TroelsG/Kinefox/Graphics/Pictures/Unassembled_casing.jpg

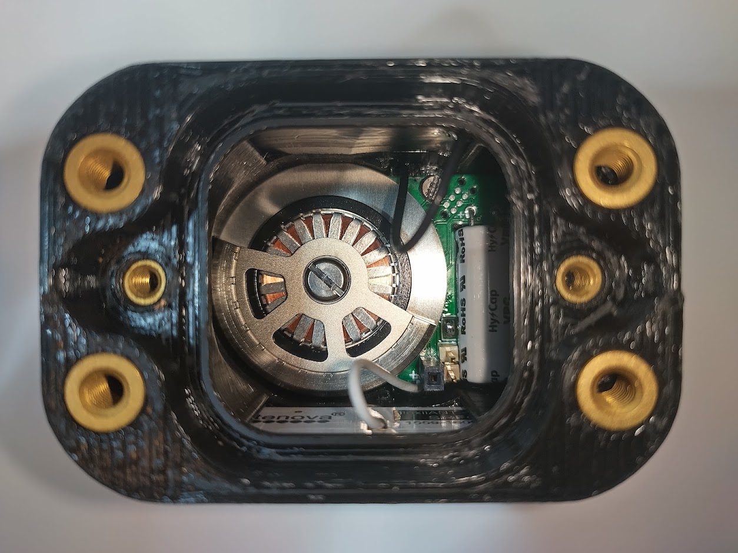
Graphics/Pictures/Unassembled_casing.jpg
