TroelsG/Kinefox/Graphics/Pictures/Assembled_collar.jpg

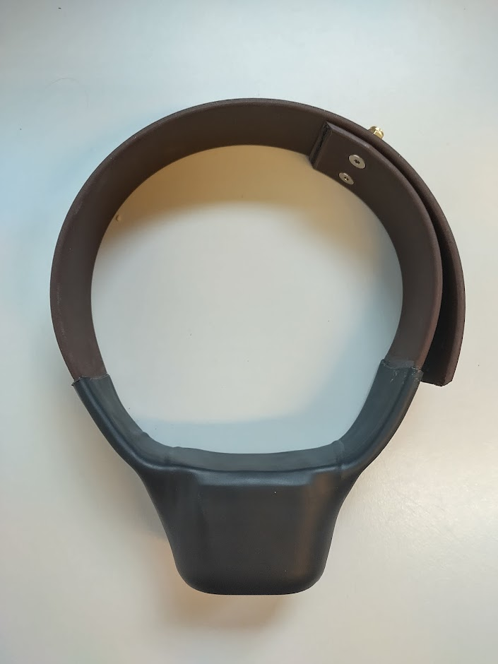
Graphics/Pictures/Assembled_collar.jpg
