TroelsG/Kinefox/README.md

# Kinefox
The wildlife tracker powered by kinetic energy
