TroelsG/Kinefox/Graphics/Pictures/Custom_wire_antenna.jpeg

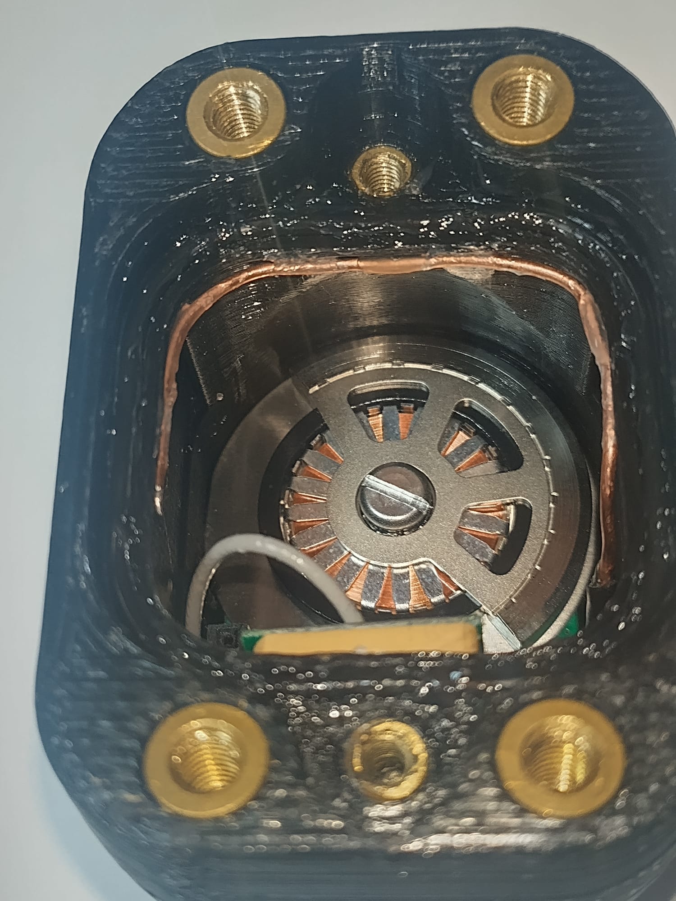
Graphics/Pictures/Custom_wire_antenna.jpeg
