TroelsG/Kinefox/Graphics/Pictures/Dog1_Balto.jpg

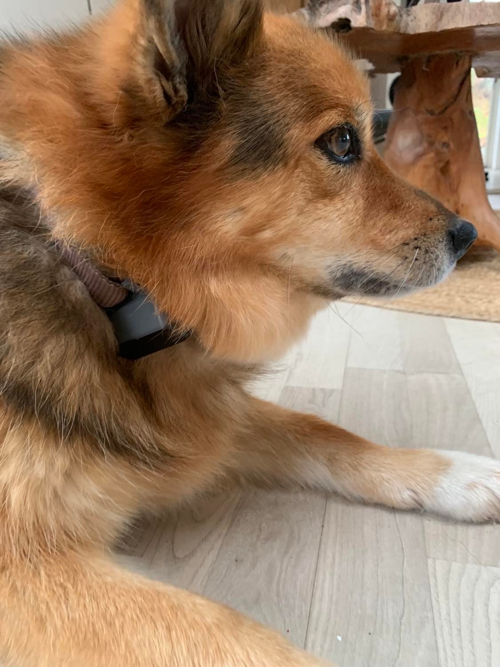
Graphics/Pictures/Dog1_Balto.jpg
