TroelsG/Kinefox/Graphics/Pictures/Dog1_Pekka1.jpeg

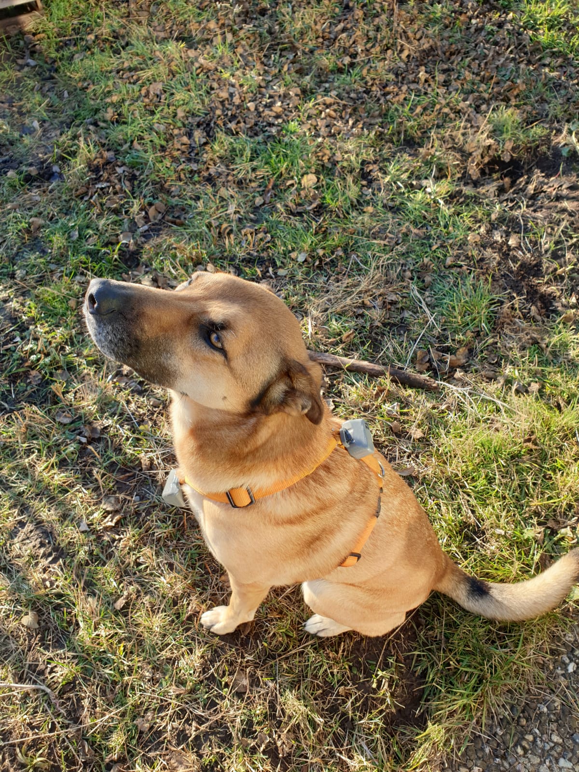
Graphics/Pictures/Dog1_Pekka1.jpeg
