TroelsG/Kinefox/Graphics/Pictures/Dog1_Pekka2.jpeg

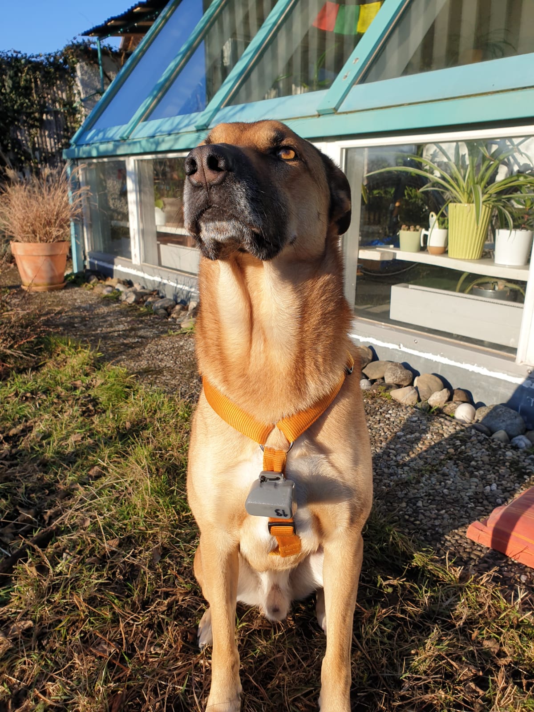
Graphics/Pictures/Dog1_Pekka2.jpeg
