TroelsG/Kinefox/Graphics/Pictures/Dog3-Comet.jpeg

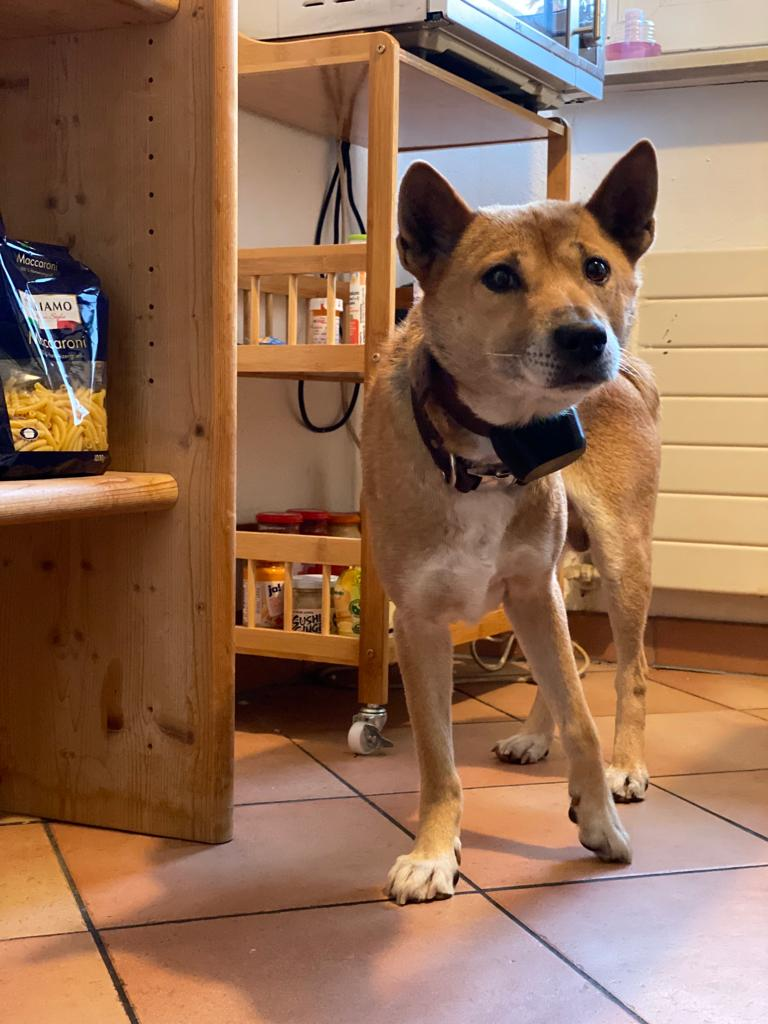
Graphics/Pictures/Dog3-Comet.jpeg
