TroelsG/Kinefox/Graphics/Pictures/Dog4_Pekka.jpg

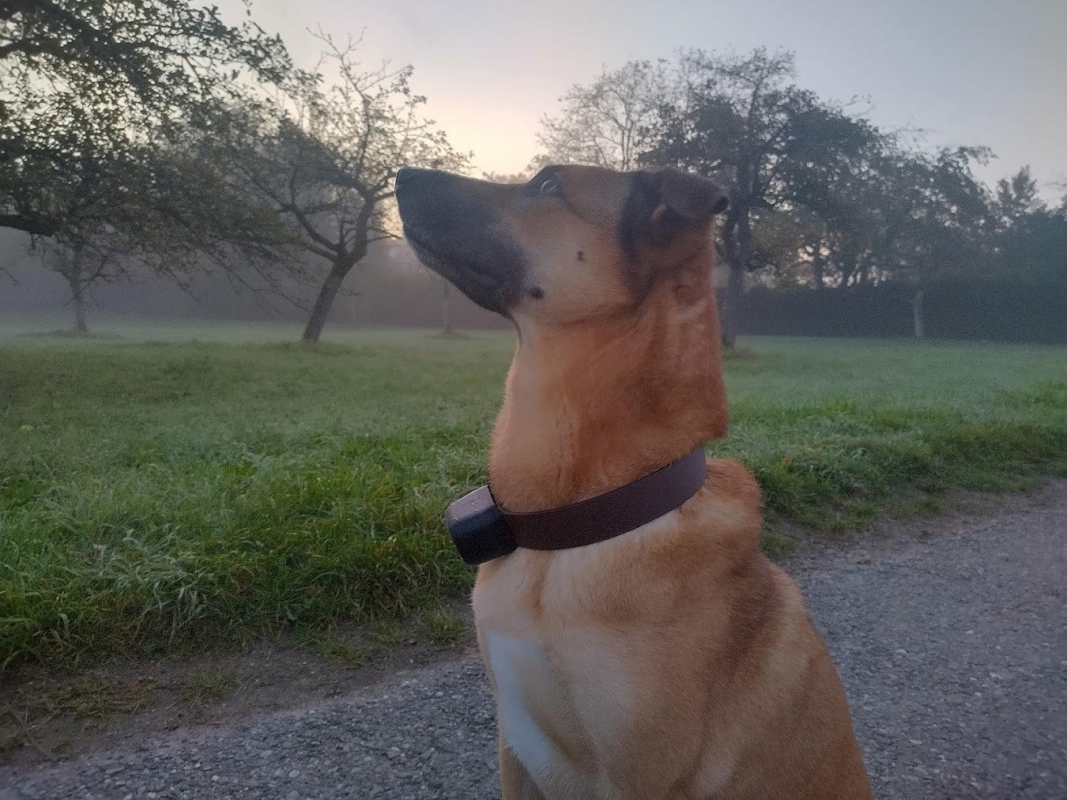
Graphics/Pictures/Dog4_Pekka.jpg
