TroelsG/Kinefox/Graphics/Pictures/Exmoor pony.jpeg

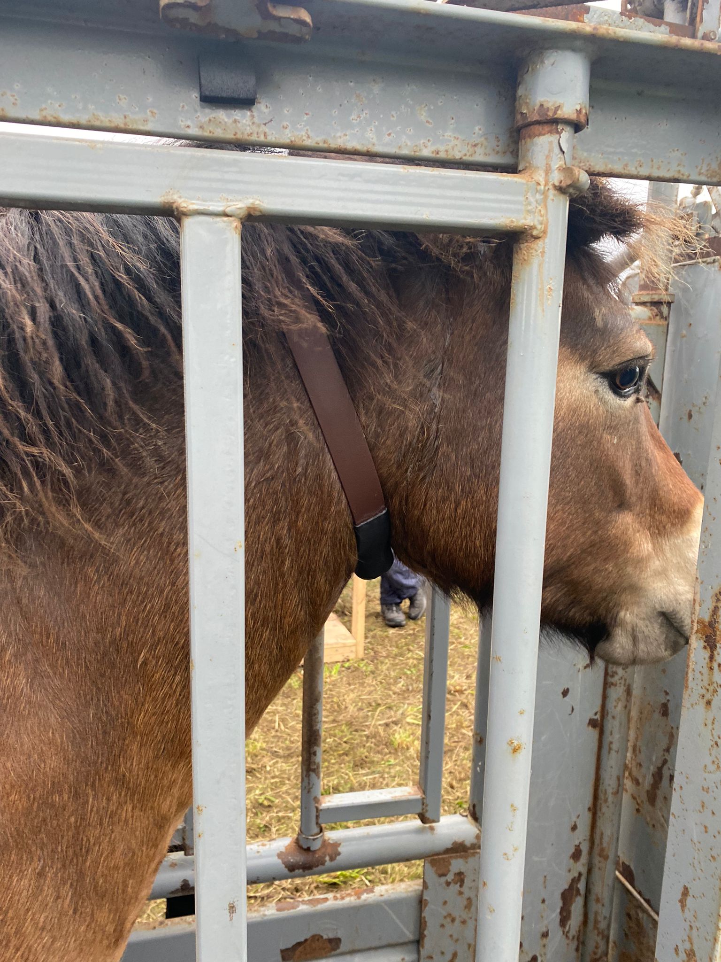
Graphics/Pictures/Exmoor pony.jpeg
