TroelsG/Kinefox/Graphics/Pictures/MSG32.jpg

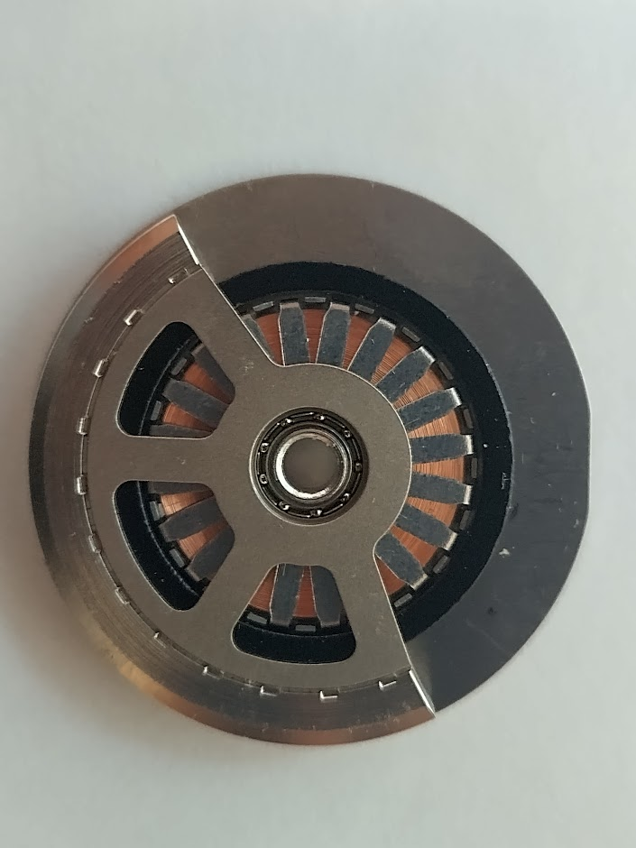
Graphics/Pictures/MSG32.jpg
