TroelsG/Kinefox/Graphics/Pictures/PCB_bottom.jpg

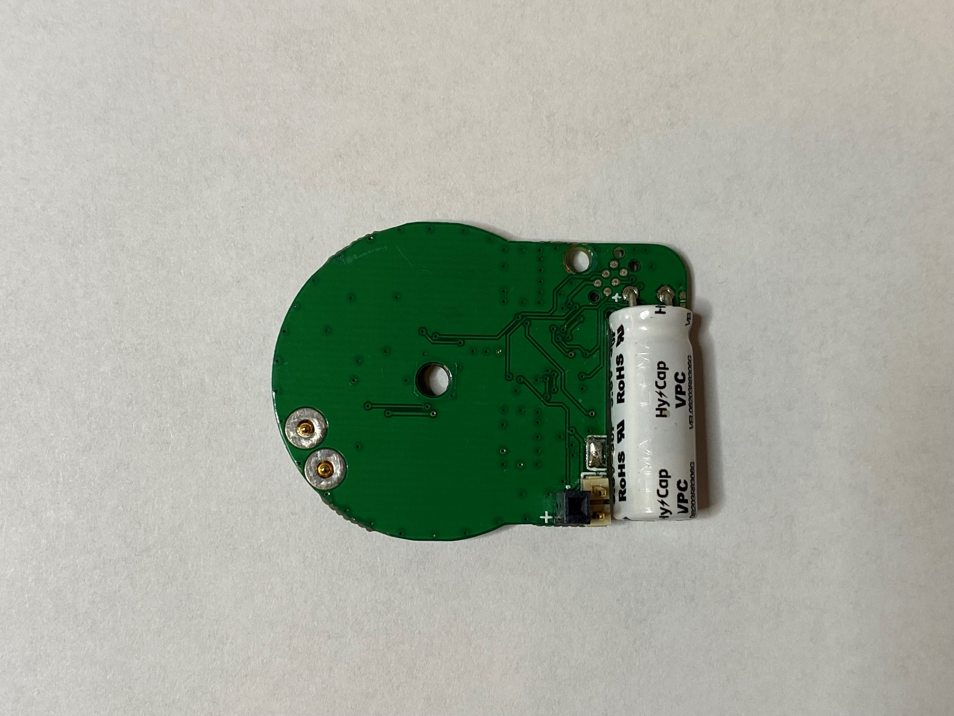
Graphics/Pictures/PCB_bottom.jpg
