TroelsG/Kinefox/Graphics/Pictures/PCB_top.jpg

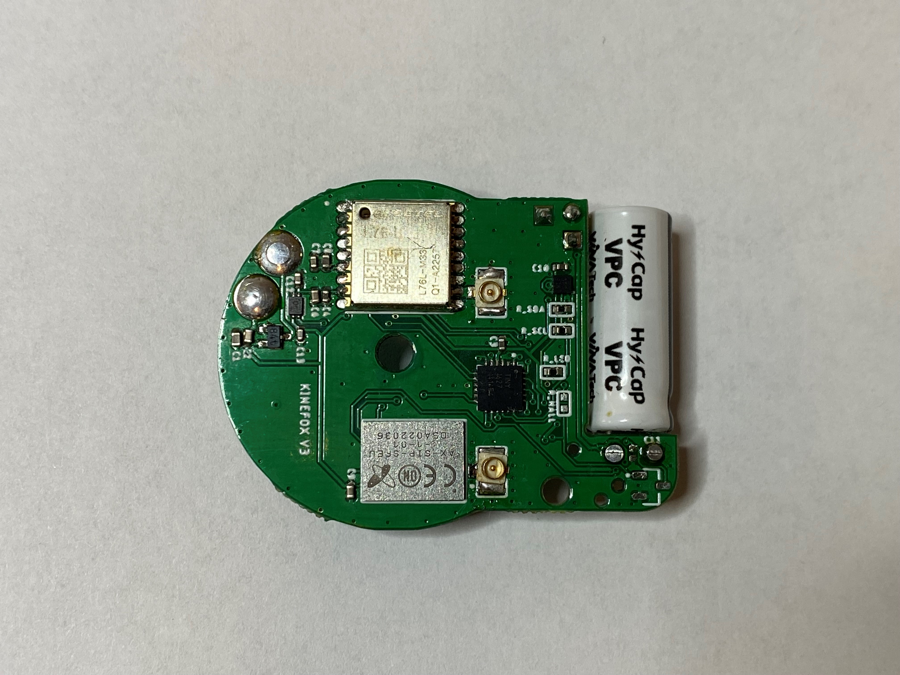
Graphics/Pictures/PCB_top.jpg
