TroelsG/Kinefox/3D/kinefox_collar_mjf_13_10_t.stl

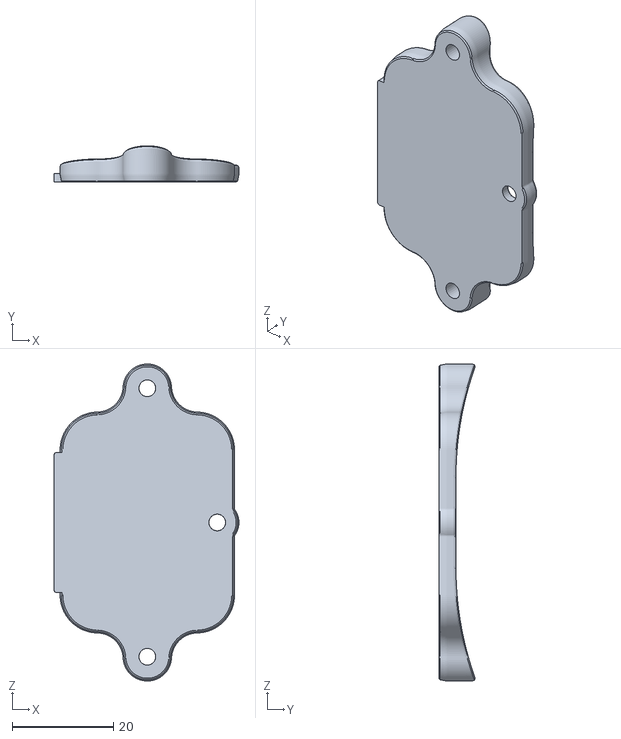
[picture p13: CAD file, 2022-10-19]
3D/kinefox_collar_mjf_13_10_t.stl
36.6 x 7.19 x 62.7
