TroelsG/Kinefox/Graphics/Pictures/Assembled_casing.jpg

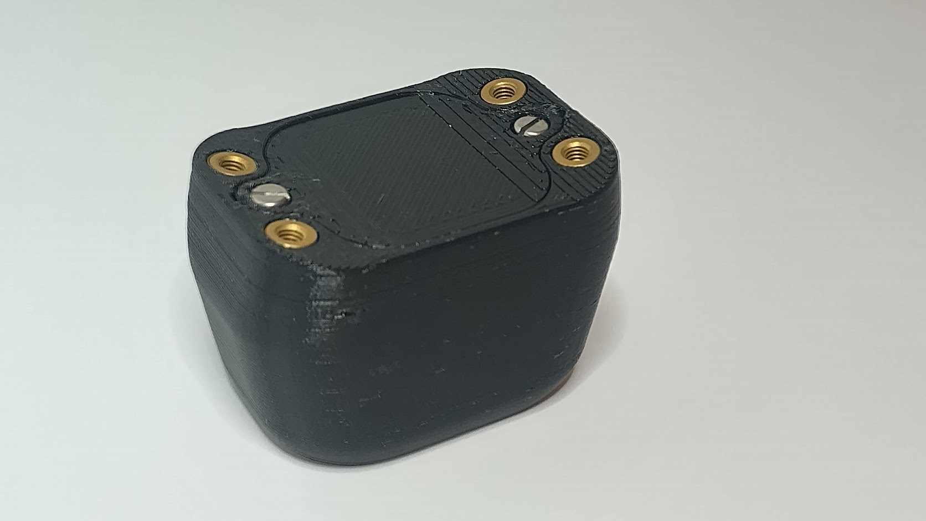
Graphics/Pictures/Assembled_casing.jpg
