TroelsG/Kinefox/Software/Backend and datavisualization/mongodb_setup.png

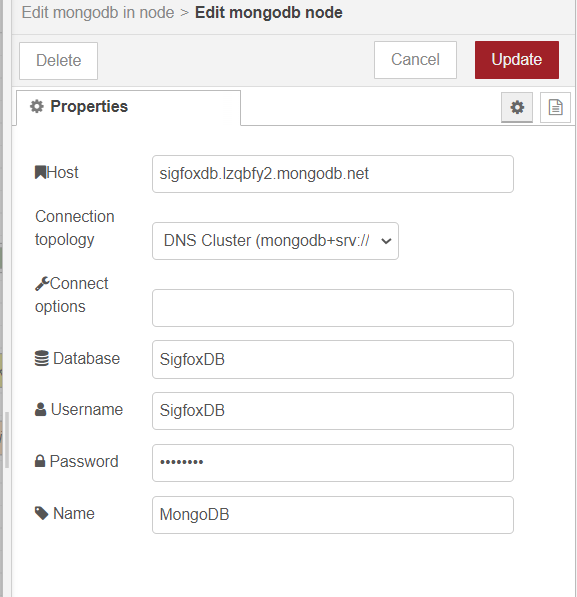
Software/Backend and datavisualization/mongodb_setup.png
