TroelsG/Kinefox/Data/Raw data/V2/Experiment6_raw.xlsx

Radius (Computed location) | Longitude (Computed location) | Latitude (Computed location) | Data | Device ID | Operator | Sequence number | Timestamp
11600 | 8.992549703 | 47.66024954 | 0dc7 | 0121E1AC | SIGFOX_Switzerland_Heliot | 262 | 2022-11-09 05:12
12100 | 8.993453795 | 47.66117825 | 0d9b | 0121E1AC | SIGFOX_Switzerland_Heliot | 257 | 2022-11-04 05:26
