TroelsG/Kinefox/Data/Raw data/V2/Experiment5_raw.xlsx

Radius (Computed location) | Longitude (Computed location) | Latitude (Computed location) | Data | Device ID | Operator | Sequence number | Timestamp
4700 | 9.158739527 | 47.67973634 | 0d41 | 0121E1B3 | SIGFOX_Germany | 440 | 2022-11-08 04:29
5500 | 9.161719671 | 47.67947305 | 0d3e | 0121E1B3 | SIGFOX_Germany | 439 | 2022-11-07 04:39
5900 | 9.161324426 | 47.67332498 | 0d3e | 0121E1B3 | SIGFOX_Germany | 438 | 2022-11-06 04:49
4800 | 9.159900314 | 47.67561771 | 0d3e | 0121E1B3 | SIGFOX_Switzerland_Heliot | 437 | 2022-11-05 05:00
4700 | 9.160274779 | 47.68070986 | 0d3e | 0121E1B3 | SIGFOX_Germany | 436 | 2022-11-04 05:10
4800 | 9.158359803 | 47.67809783 | 0d3e | 0121E1B3 | SIGFOX_Germany | 435 | 2022-11-03 05:20
4600 | 9.15850233 | 47.67786837 | 0d3b | 0121E1B3 | SIGFOX_Switzerland_Heliot | 434 | 2022-11-02 05:30
4700 | 9.167033277 | 47.66413409 | 0d3b | 0121E1B3 | SIGFOX_Germany | 433 | 2022-11-01 05:40
4000 | 9.158360973 | 47.68200045 | 0d33 | 0121E1B3 | SIGFOX_Germany | 432 | 2022-10-31 05:50
5900 | 9.16266917 | 47.67116002 | 0d36 | 0121E1B3 | SIGFOX_Germany | 431 | 2022-10-30 06:00
4600 | 9.161324426 | 47.67332498 | 0d31 | 0121E1B3 | SIGFOX_Germany | 430 | 2022-10-29 07:10
6000 | 9.161956761 | 47.67230696 | 0d33 | 0121E1B3 | SIGFOX_Germany | 429 | 2022-10-28 07:21
5200 | 9.161589563 | 47.68023431 | 0d33 | 0121E1B3 | SIGFOX_Germany | 428 | 2022-10-27 07:31
5700 | 9.159288231 | 47.67660312 | 0d36 | 0121E1B3 | SIGFOX_Germany | 427 | 2022-10-26 07:42
