TroelsG/Kinefox/Hardware/PCB/Kinefox_v4/Kinefox_6.brd

## EAGLE design Hardware/PCB/Kinefox_v4/Kinefox_6.brd (2022-10-19)

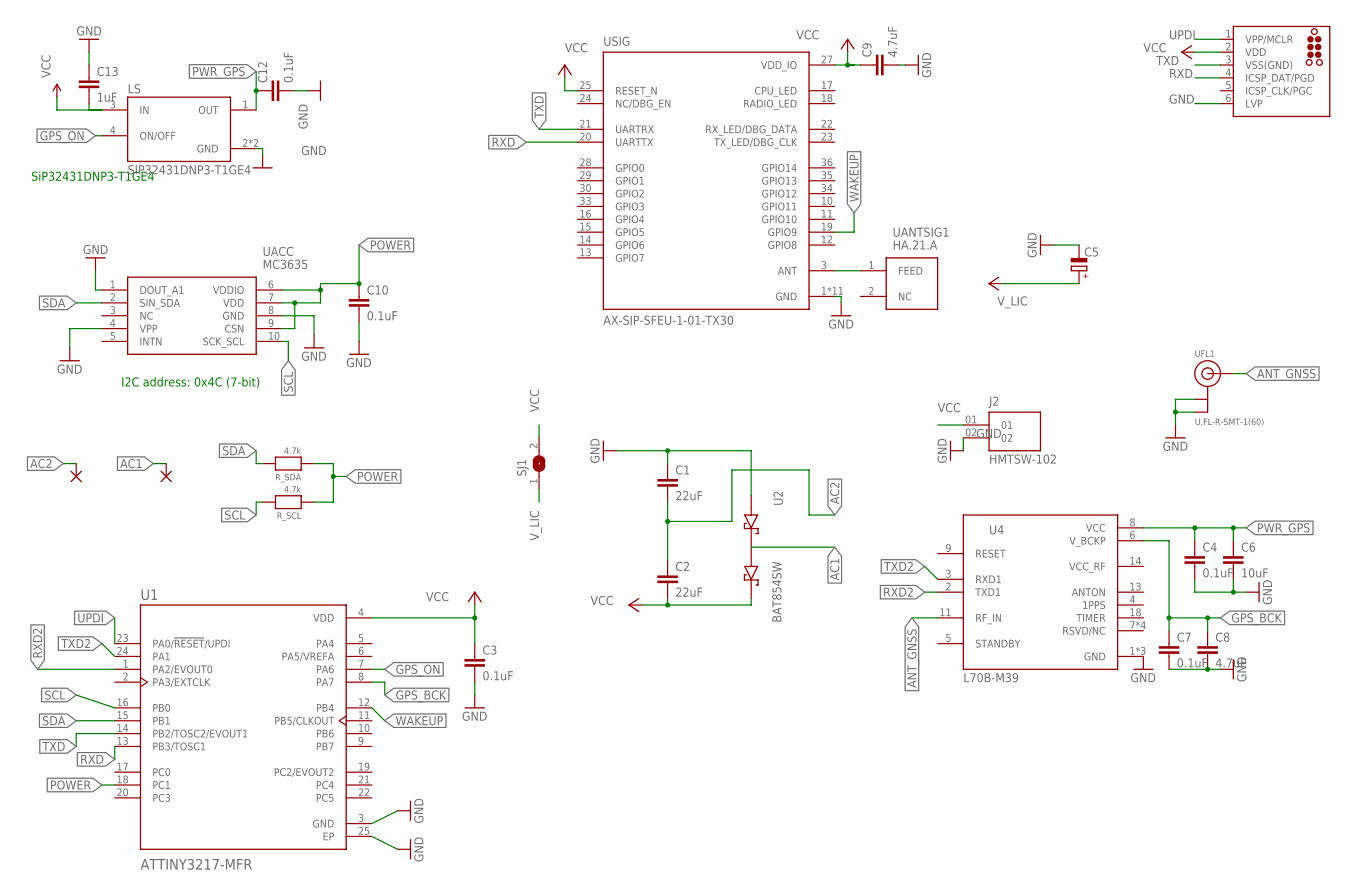
[picture p16: schematic Kinefox_6.sch]

Parts:
C1, C2: 22uF; C0402
C3, C4, C7, C10, C12: 0.1uF; C0402
C5: CPOL-EUE3.5-8; E3,5-8
C6: 10uF; C0402
C8, C9: 4.7uF; C0402
C13: 1uF; C0402
J1: TC2030-MCP-NL
J2: HMTSW-102; SAMTEC_HMTSW-102-XX-X-S-XXX
LS: SIP32431DNP3-T1GE4; SON50P120X160X60-5N
PAD1, PAD2: WIREPAD2,54/1,1; 2,54/1,1
R_SCL: 4.7k; MICROBUILDER__0402
R_SDA: 4.7k; MICROBUILDER__0402
SJ1: SJ
U1: ATTINY3217-MFR; QFN50P400X400X90-25N
U2: BAT854SW; SOT323
U4: L70B-M39; XCVR_L70B-M39
UACC: MC3635
UANTSIG1: HA.21.A
UFL1: U.FL-R-SMT-1(60); U.FL
USIG: AX-SIP-SFEU-1-01-TX30; IC_AX-SIP-SFEU-1-01-TX30

Connections:
AC1: PAD1.1, U2.1 (PIN3)
AC2: C1.2, C2.1, PAD2.1
ANT_GNSS: U4.11 (RF_IN), UFL1.3 (SIGNAL)
ANT_SIGFOX: UANTSIG1.1 (FEED), USIG.3 (ANT)
GND: C1.1, C3.2, C4.2, C5.-, C6.2, C7.2, C8.2, C9.2, C10.2, C12.2, C13.1, J1.6 (LVP), J2.02, LS.2 (GND), LS.5 (GND), U1.3 (GND), U1.25 (EP), U2.2 (PIN1), U4.1 (GND), U4.10 (GND), U4.12 (GND), UACC.1 (DOUT_A1), UACC.4 (VPP), UACC.8 (GND), UFL1.1 (GND), UFL1.2 (GND), USIG.1 (GND), USIG.2 (GND), USIG.4 (GND), USIG.6 (GND), USIG.26 (GND), USIG.P1 (GND), USIG.P2 (GND), USIG.P3 (GND), USIG.P4 (GND), USIG.P5 (GND), USIG.P6 (GND)
GPS_BCK: C7.1, C8.1, U1.8 (PA7), U4.6 (V_BCKP)
GPS_ON: LS.4 (ON/OFF), U1.7 (PA6)
POWER: C10.1, R_SCL.1, R_SDA.1, U1.18 (PC1), UACC.6 (VDDIO), UACC.7 (VDD), UACC.9 (CSN)
PWR_GPS: C4.1, C6.1, C12.1, LS.1 (OUT), U4.8 (VCC)
RXD: J1.4 (ICSP_DAT/PGD), U1.13 (PB3/TOSC1), USIG.20 (UARTTX)
RXD2: U1.1 (PA2/EVOUT0), U4.2 (TXD1)
SCL: R_SCL.2, U1.16 (PB0), UACC.10 (SCK_SCL)
SDA: R_SDA.2, U1.15 (PB1), UACC.2 (SIN_SDA)
TXD: J1.3 (VSS(GND)), U1.14 (PB2/TOSC2/EVOUT1), USIG.21 (UARTRX)
TXD2: U1.24 (PA1), U4.3 (RXD1)
UPDI: J1.1 (VPP/MCLR), U1.23 (PA0/!RESET!/UPDI)
VCC: C2.2, C3.1, C9.1, C13.2, J1.2 (VDD), J2.01, LS.3 (IN), SJ1.2, U1.4 (VDD), U2.3 (PIN2), USIG.25 (RESET_N), USIG.27 (VDD_IO)
V_LIC: C5.+, SJ1.1
WAKEUP: U1.12 (PB4), USIG.19 (GPIO9)

Notes on the sheet:
I2C address: 0x4C (7-bit)
SiP32431DNP3-T1GE4

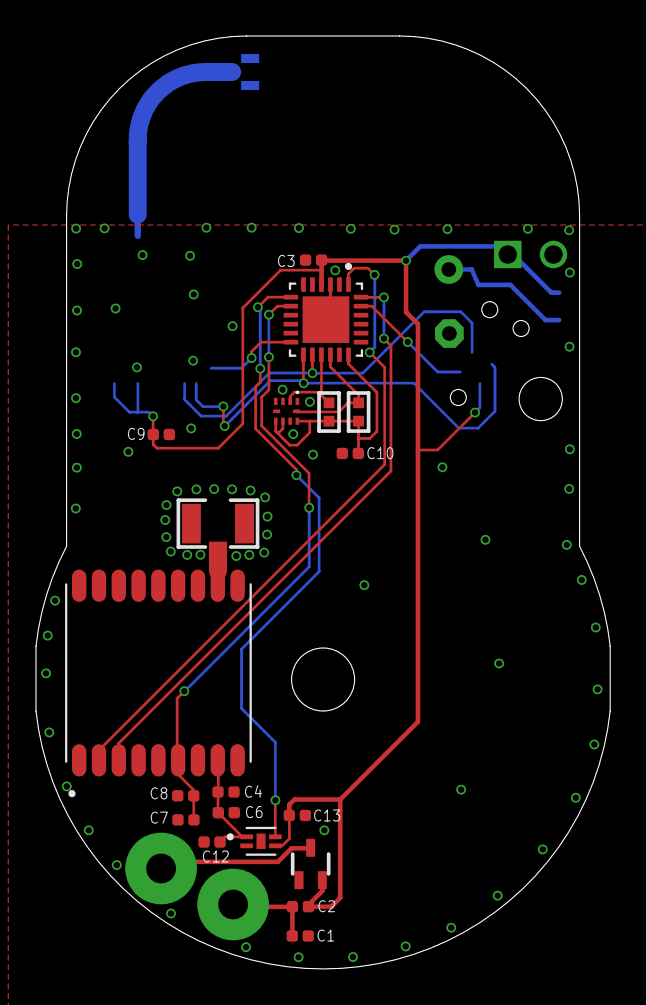
[picture p17: board Kinefox_6.brd from above]

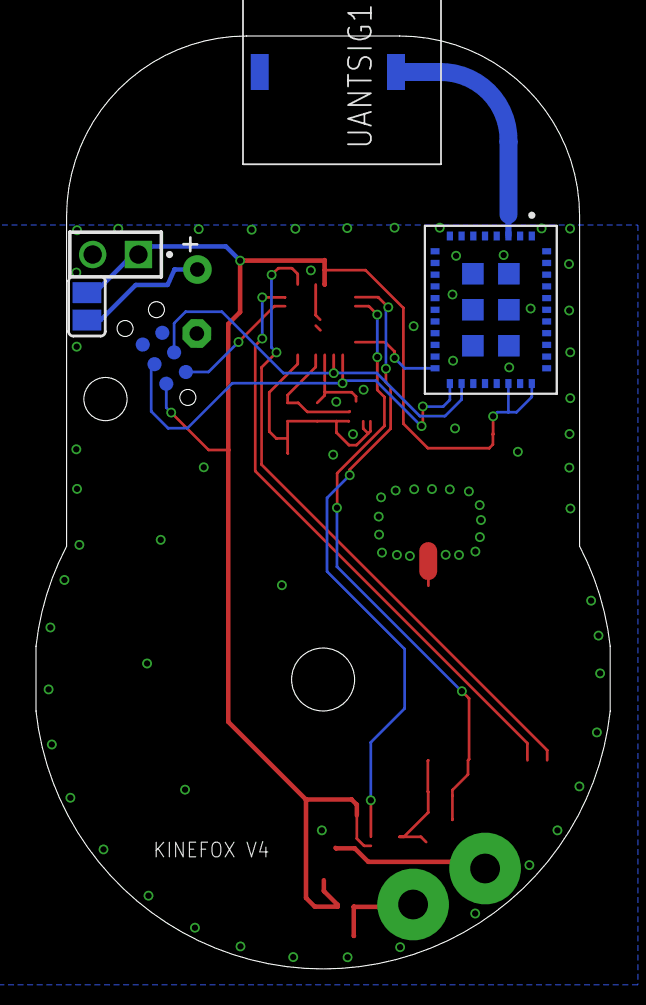
[picture p18: board Kinefox_6.brd from below]

Board: 2 copper layers, 31.9 x 51.8 mm, 27 parts (6 on the bottom side), 19 nets.
