TroelsG/Kinefox/Hardware/PCB/Kinefox_v1/KineticHarvester_SIG_UFL_eRIC/KineticHarvester_SIG_UFL_5.brd

## EAGLE design Hardware/PCB/Kinefox_v1/KineticHarvester_SIG_UFL_eRIC/KineticHarvester_SIG_UFL_5.brd (2023-05-02, an earlier design)

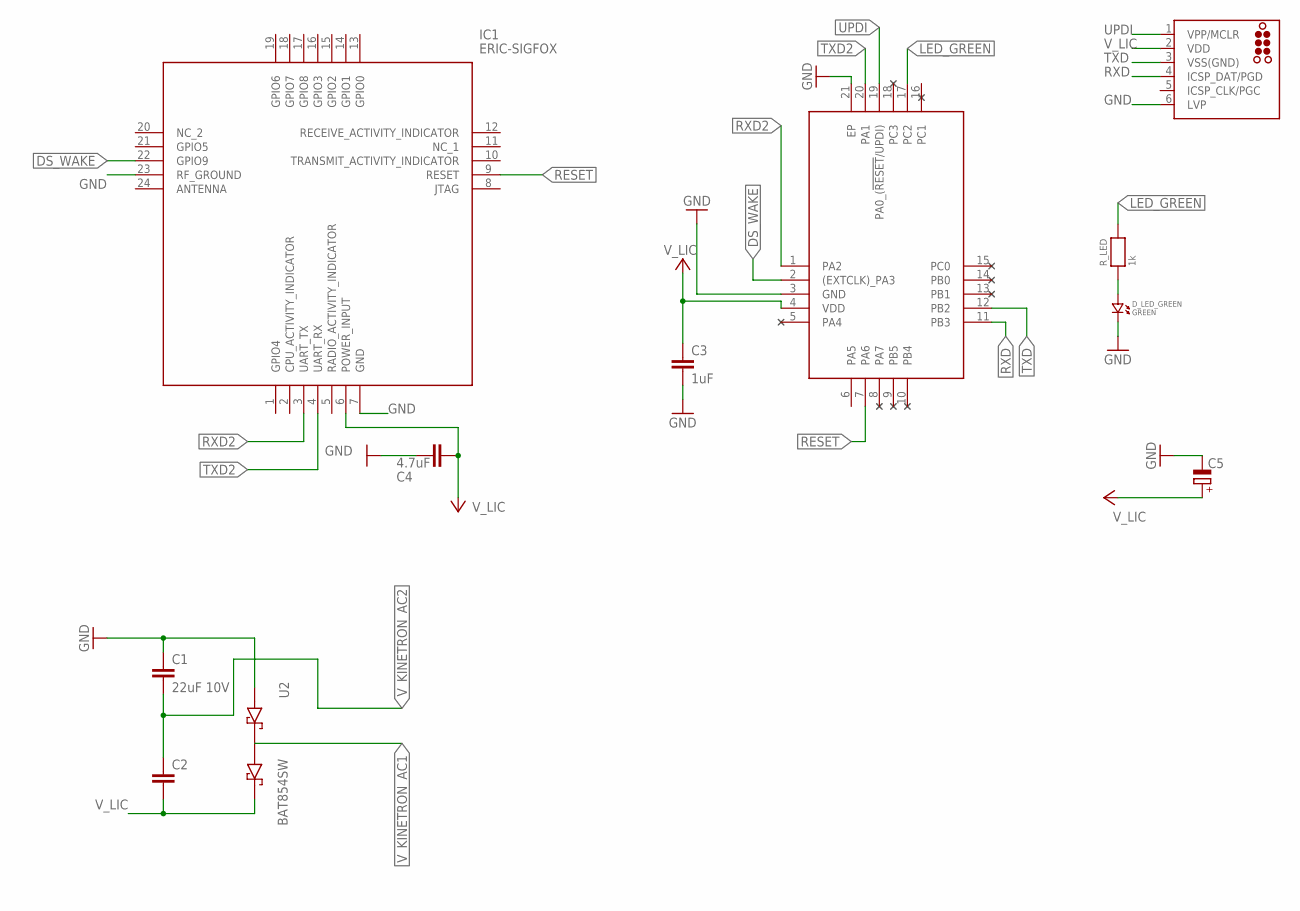
[picture p19: schematic KineticHarvester_SIG_UFL_5.sch]

Parts:
ATTINY: ATTINY1616-MFR; QFN40P300X300X90-21N
C1, C2: 22uF 10V; C0603
C3: 1uF; C0402
C4: 4.7uF; C0402
C5: CPOL-EUE3.5-8; E3,5-8
D_LED_GREEN: GREEN; CMONR_STANDARDPARTS_0402.LED
IC1: ERIC-SIGFOX; ERICSIGFOX
J1: TC2030-MCP-NL
R_LED: 1k; MICROBUILDER__0402MP
U2: BAT854SW; SOT323

Connections:
DS_WAKE: ATTINY.2 ((EXTCLK)_PA3), IC1.22 (GPIO9)
GND: ATTINY.3 (GND), ATTINY.21 (EP), C1.1, C3.2, C4.2, C5.-, D_LED_GREEN.P$2 (2), IC1.7 (GND), IC1.23 (RF_GROUND), J1.6 (LVP), U2.2 (PIN1)
LED_GREEN: ATTINY.17 (PC2), R_LED.2
unnamed: D_LED_GREEN.P$1 (1), R_LED.1
RESET: ATTINY.7 (PA6), IC1.9 (RESET)
RXD: ATTINY.11 (PB3), J1.4 (ICSP_DAT/PGD)
RXD2: ATTINY.1 (PA2), IC1.3 (UART_TX)
TXD: ATTINY.12 (PB2), J1.3 (VSS(GND))
TXD2: ATTINY.20 (PA1), IC1.4 (UART_RX)
UPDI: ATTINY.19 (PA0_(!RESET!/UPDI)), J1.1 (VPP/MCLR)
V_KINETRON_AC1: U2.1 (PIN3)
V_KINETRON_AC2: C1.2, C2.1
V_LIC: ATTINY.4 (VDD), C2.2, C3.1, C4.1, C5.+, IC1.6 (POWER_INPUT), J1.2 (VDD), U2.3 (PIN2)

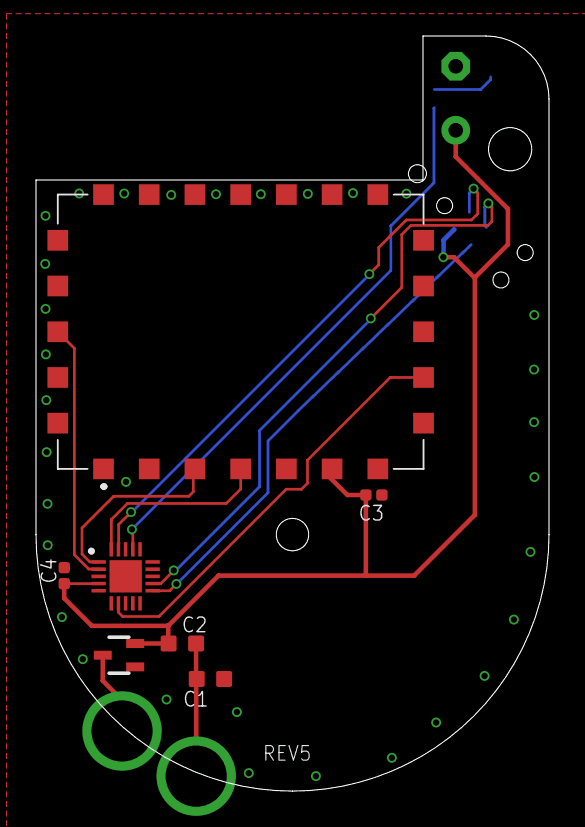
[picture p20: board KineticHarvester_SIG_UFL_5.brd from above]

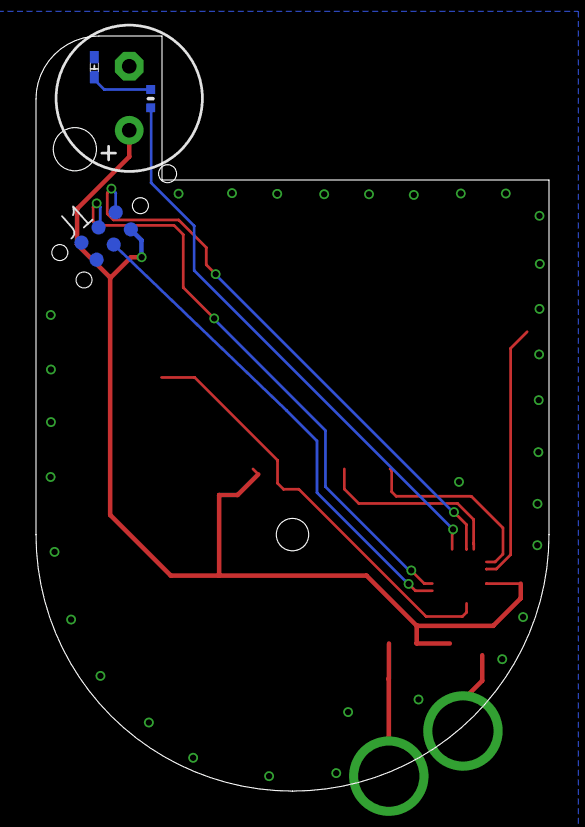
[picture p21: board KineticHarvester_SIG_UFL_5.brd from below]

Board: 2 copper layers, 28.5 x 42.0 mm, 11 parts (4 on the bottom side), 12 nets.
