TroelsG/Kinefox/(commit log)

2022-10-19 Creo files
    [kinefox_collar_mjf_13_10_t.stl]
2023-05-02 Kinefox V1 and V2
    [Cleaned_data.xlsx, Configuration.h, ConfigurationTest.h, Experiment1_raw.xlsx, Experiment2_raw.xlsx, Experiment3_raw.xlsx, Experiment4_raw.xlsx, Experiment5_journal.xlsx]
2023-05-02 Rearrange folders
    [Cleaned_data.xlsx, Experiment1_raw.xlsx, Experiment2_raw.xlsx, Experiment3_raw.xlsx, Experiment4_raw.xlsx, Experiment5_journal.xlsx, Experiment5_raw.xlsx, Experiment6_journal.xlsx]
2023-05-02 Deleted old folder
    [kinefox_collar_mjf_13_10_t.stl]
