TroelsG/Kinefox/(notices)

Notices in the files:
parts and their libraries:
tag-connect: ©2009 ROFA.cz - modified and updated by Robert Darlington ‹rdarlington@gmail.com›
SparkFun-PowerSymbols: Licensing: Creative Commons ShareAlike 4.0 International - https://creativecommons.org/licenses/by-sa/4.0
